craiglink/Voron-2/printer_mods/hartk1213/Voron2.4_GE5C/CAD/GE5C.step

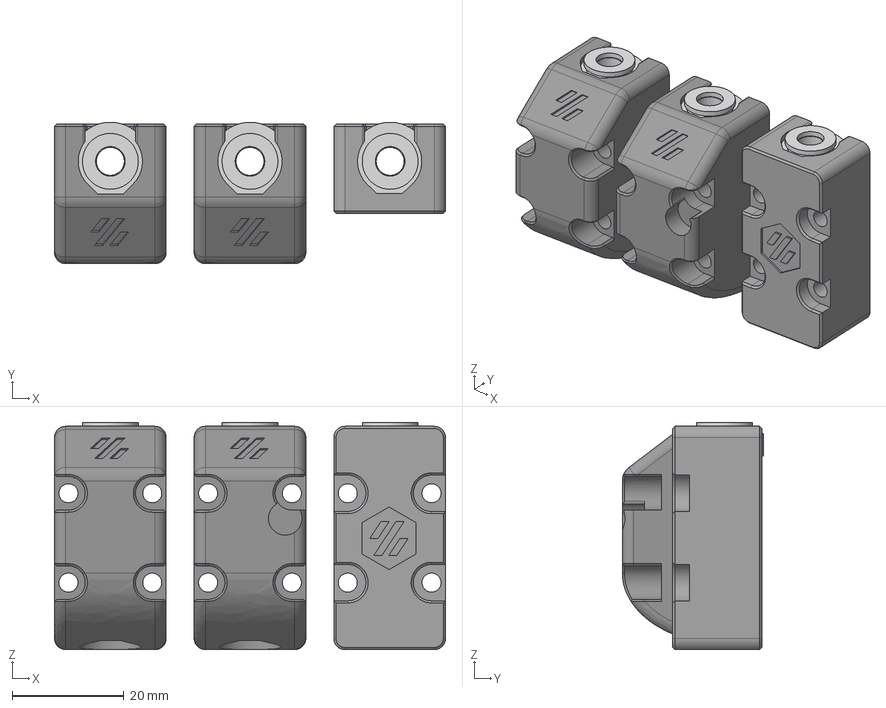
[picture p1: CAD file, 2021-08-20]
printer_mods/hartk1213/Voron2.4_GE5C/CAD/GE5C.step
70.0 x 25.3 x 40.7 mm
M5 1mm Spacer v1 (1)
GE5C v1
M5 1mm Spacer v1 (1) (1)
GE5C v1 (1)
M5 1mm Spacer v1 (1) (2)
GE5C v1 (2)
