craiglink/Voron-2/printer_mods/hartk1213/Voron2.4_GE5C/STLs/Gantry/AB Drives/b_drive_frame_lower_g5ec_offset_pinned.stl

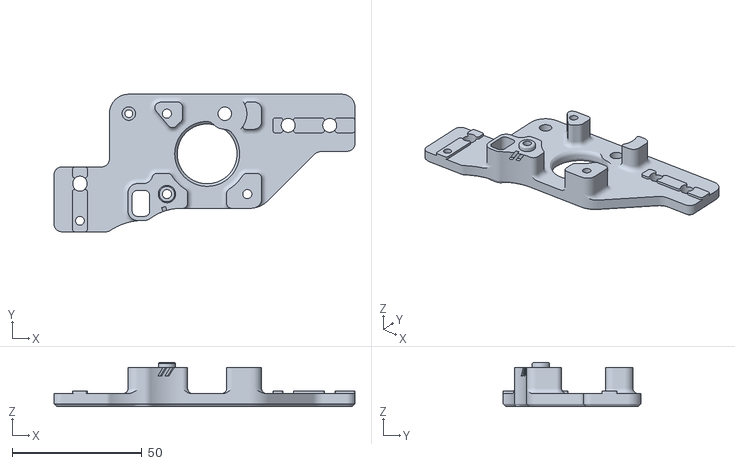
[picture p3: CAD file, 2021-08-20]
printer_mods/hartk1213/Voron2.4_GE5C/STLs/Gantry/AB Drives/b_drive_frame_lower_g5ec_offset_pinned.stl
116.0 x 53.0 x 17.0
