craiglink/Voron-2/printer_mods/hartk1213/Voron2.4_GE5C/STLs/Z_Joints/z_joint_ge5c_x4.stl

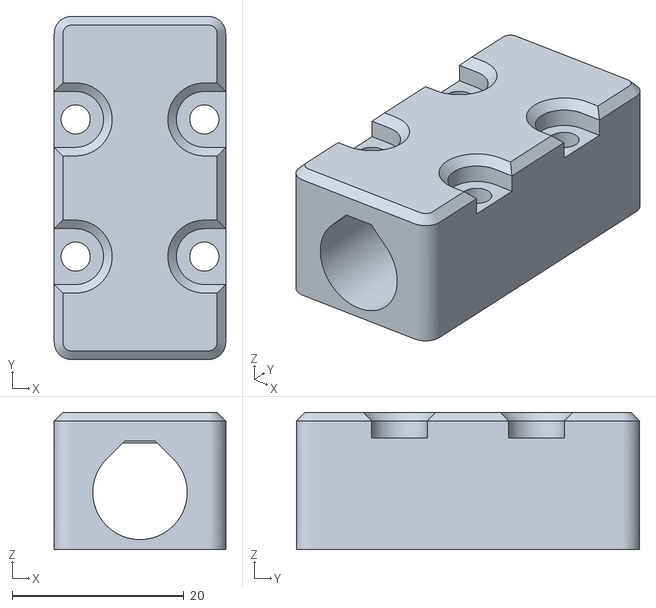
[picture p5: CAD file, 2021-08-20]
printer_mods/hartk1213/Voron2.4_GE5C/STLs/Z_Joints/z_joint_ge5c_x4.stl
20.0 x 40.0 x 16.0
