craiglink/Voron-2/printer_mods/hartk1213/Voron2.4_Pins_Mod/CAD/Gantry/AB_Drive_Units/a_drive_frame_lower_pinned.step

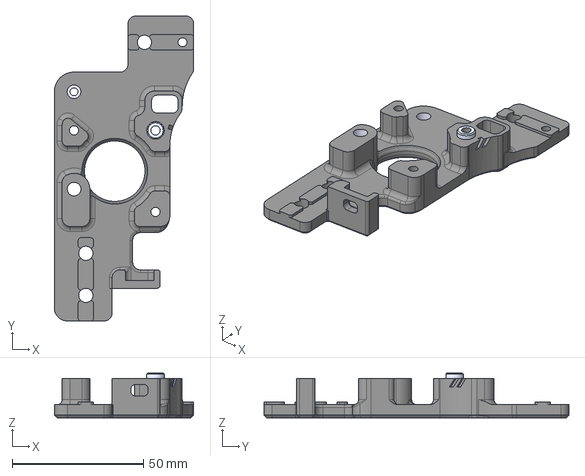
[picture p6: CAD file, 2021-08-20]
printer_mods/hartk1213/Voron2.4_Pins_Mod/CAD/Gantry/AB_Drive_Units/a_drive_frame_lower_pinned.step
53.0 x 116.0 x 17.0 mm
