craiglink/Voron-2/printer_mods/hartk1213/Voron2.4_Pins_Mod/CAD/Gantry/Front_Idlers/[a]_tensioner_right_pinned.step

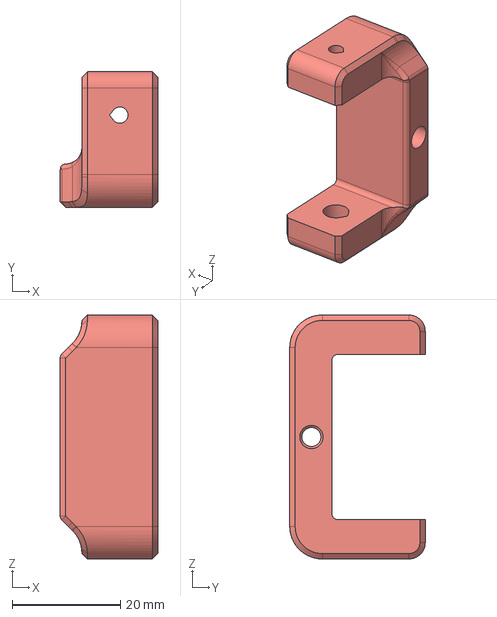
[picture p7: CAD file, 2021-08-20]
printer_mods/hartk1213/Voron2.4_Pins_Mod/CAD/Gantry/Front_Idlers/[a]_tensioner_right_pinned.step
18.0 x 25.0 x 45.0 mm
