craiglink/Voron-2/printer_mods/hartk1213/Voron2.4_Pins_Mod/CAD/Z_Idlers/z_Idler_pinned.step

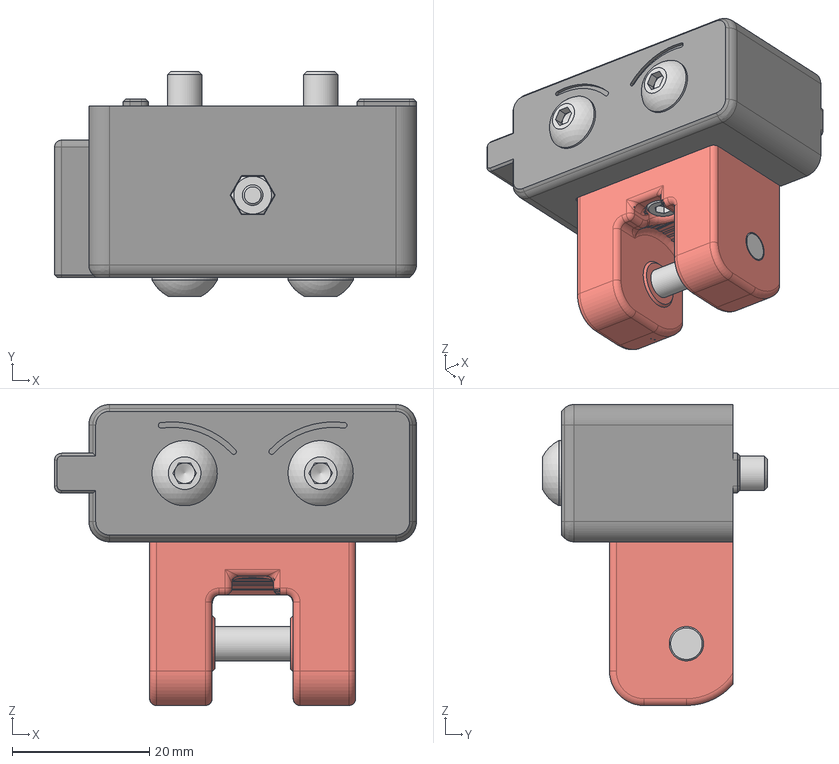
[picture p9: CAD file, 2021-08-20]
printer_mods/hartk1213/Voron2.4_Pins_Mod/CAD/Z_Idlers/z_Idler_pinned.step
52.7 x 32.8 x 43.8 mm
Z Tensioner 9mm
Z Tensioner 6mm
M5x30 BHCS (1) x 2
M3 Hexnut
M3x16 SHCS
