craiglink/Voron-2/printer_mods/hartk1213/Voron2.4_Pins_Mod/STLs/Gantry/AB_Drive_Units/a_drive_frame_upper_pinned-1.5extension.stl

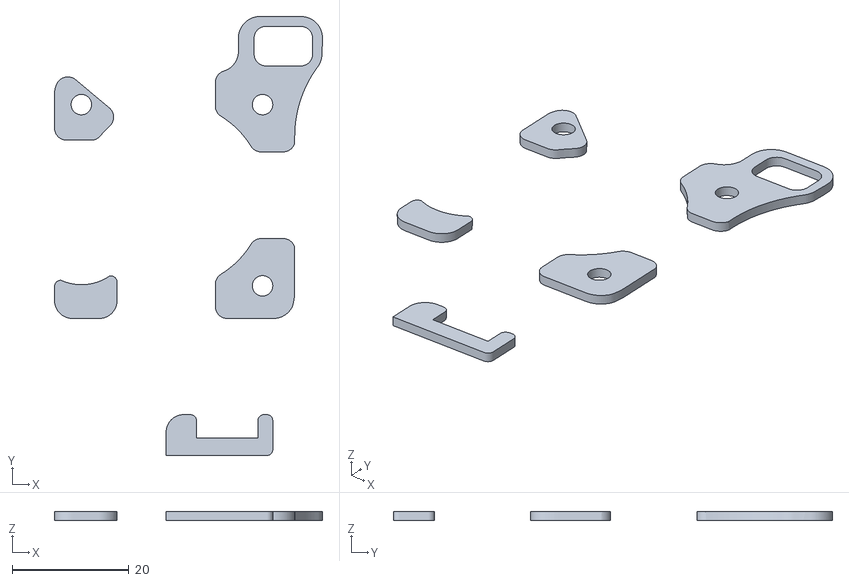
[picture p10: CAD file, 2021-08-20]
printer_mods/hartk1213/Voron2.4_Pins_Mod/STLs/Gantry/AB_Drive_Units/a_drive_frame_upper_pinned-1.5extension.stl
45.8 x 75.1 x 1.50
