craiglink/Voron-2/printer_mods/Long/Mantis_Dual_5015/1.8/Duct_v1.037_Left_+2mm.stl

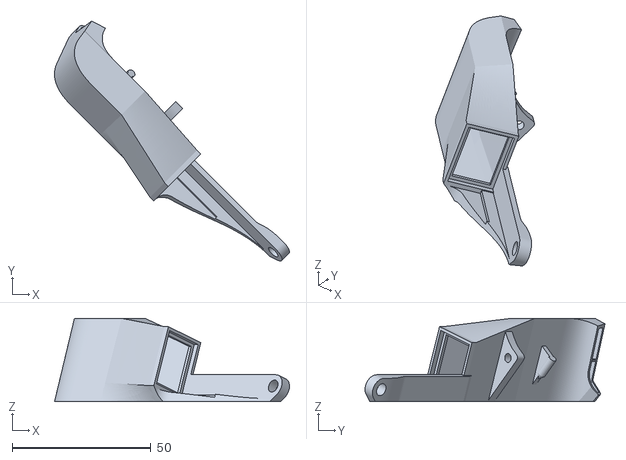
[picture p13: CAD file, 2021-08-20]
printer_mods/Long/Mantis_Dual_5015/1.8/Duct_v1.037_Left_+2mm.stl
84.6 x 86.4 x 30.0
