craiglink/Voron-2/printer_mods/Long/Mantis_Dual_5015/2.4/Duct_v1.037_Right.stl

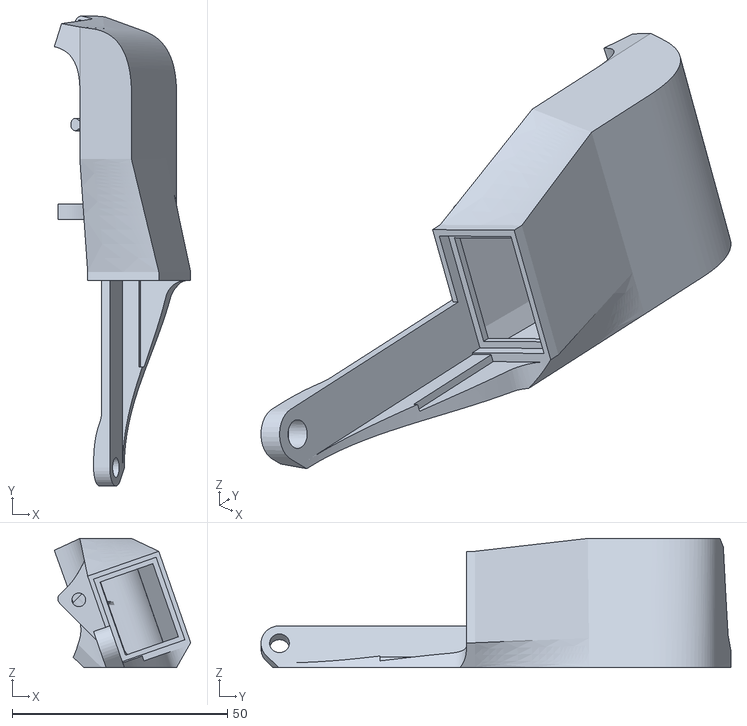
[picture p14: CAD file, 2021-08-20]
printer_mods/Long/Mantis_Dual_5015/2.4/Duct_v1.037_Right.stl
31.7 x 109.2 x 30.0
