craiglink/Voron-2/printer_mods/Long/Mantis_Dual_5015/Magprobe/Bed_Extrusion_Mount/Magprobe_Dock_Mount_v1.0.stl

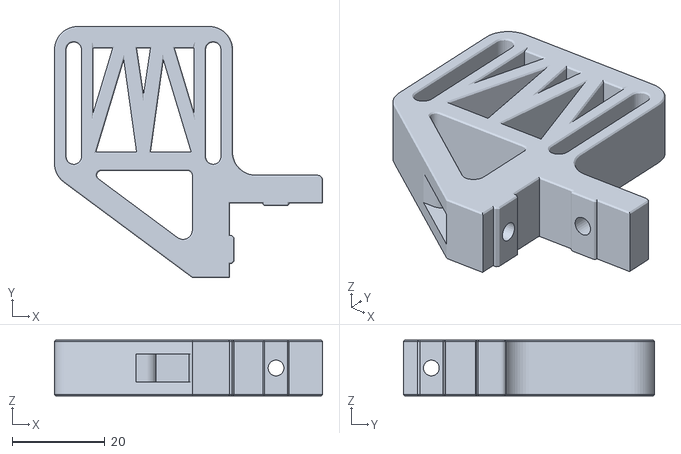
[picture p15: CAD file, 2021-08-20]
printer_mods/Long/Mantis_Dual_5015/Magprobe/Bed_Extrusion_Mount/Magprobe_Dock_Mount_v1.0.stl
57.6 x 54.0 x 12.0
