craiglink/Voron-2/printer_mods/Long/Mantis_Dual_5015/Magprobe/Gantry_Mount/Magprobe_Gantry_Dock_Arm_v1.5_Single_magnet.stl

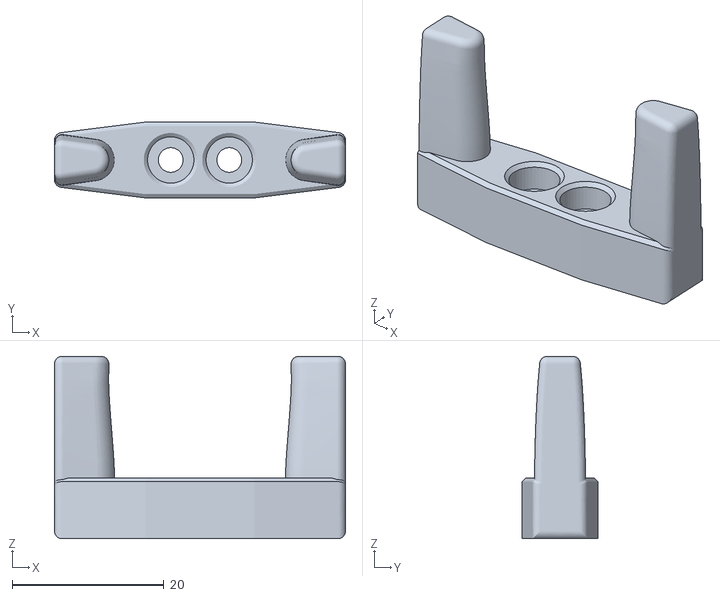
[picture p16: CAD file, 2021-08-20]
printer_mods/Long/Mantis_Dual_5015/Magprobe/Gantry_Mount/Magprobe_Gantry_Dock_Arm_v1.5_Single_magnet.stl
38.3 x 10.0 x 24.0
