craiglink/Voron-2/printer_mods/Long/Mantis_Dual_5015/Magprobe/Magprobe_v0.31.stl

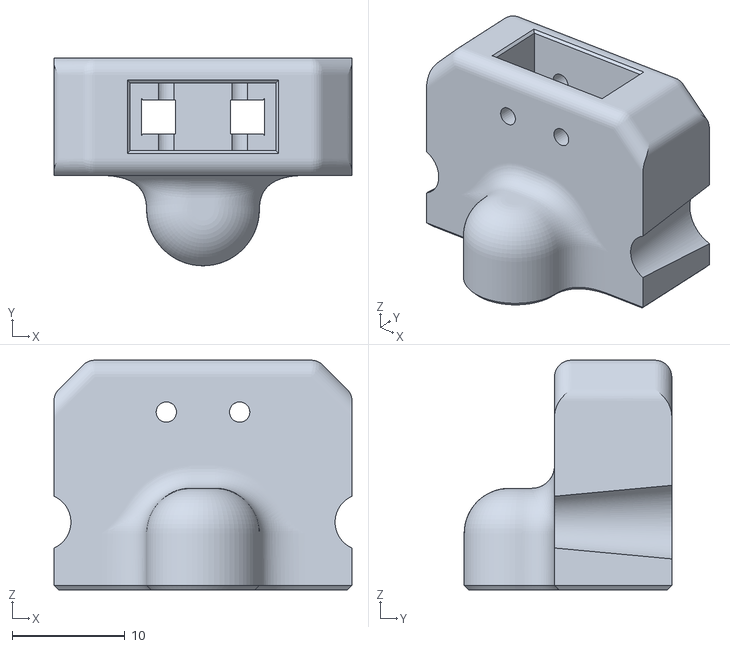
[picture p17: CAD file, 2021-08-20]
printer_mods/Long/Mantis_Dual_5015/Magprobe/Magprobe_v0.31.stl
26.4 x 18.4 x 20.4
