craiglink/Voron-2/printer_mods/Long/Mantis_Dual_5015/Umbilical_mount_v2.stl

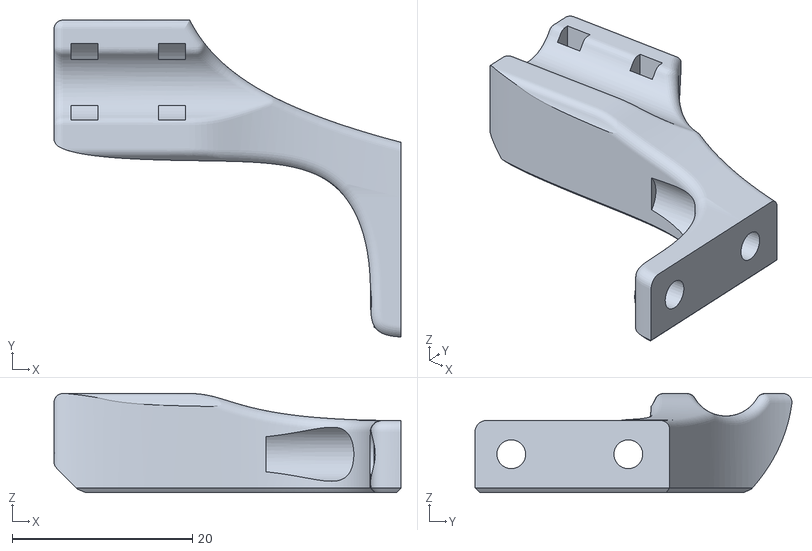
[picture p18: CAD file, 2021-08-20]
printer_mods/Long/Mantis_Dual_5015/Umbilical_mount_v2.stl
38.6 x 35.2 x 11.0
