craiglink/Voron-2/printer_mods/whoppingpochard/extrusion_backers/DXFs/Y_backer_chain-350.dxf

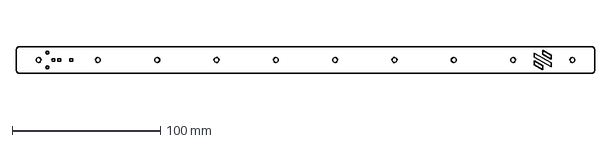
[picture p19: CAD file, 2021-08-20]
printer_mods/whoppingpochard/extrusion_backers/DXFs/Y_backer_chain-350.dxf
390.0 x 18.0 mm
