craiglink/Voron-2/printer_mods/hartk1213/Voron2.4_GE5C/STLs/Gantry/Front Idlers/a_idler_lower_g5ec_offset.stl

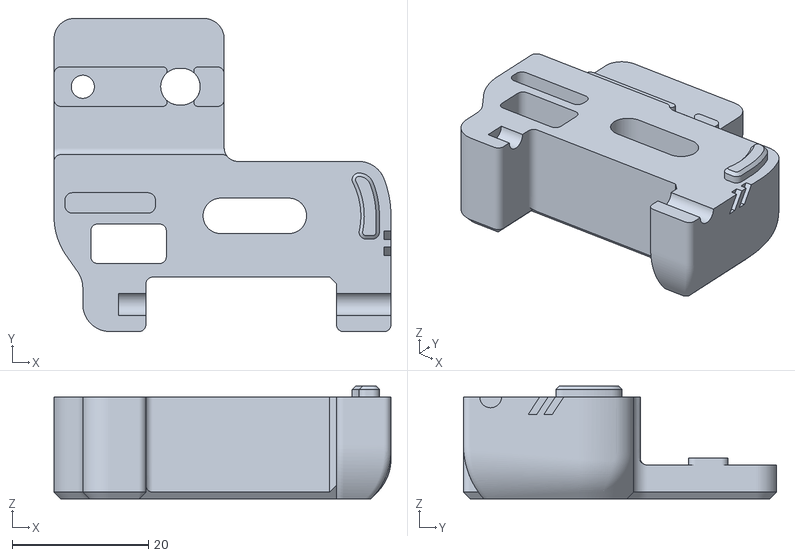
[picture p20: CAD file, 2021-08-20]
printer_mods/hartk1213/Voron2.4_GE5C/STLs/Gantry/Front Idlers/a_idler_lower_g5ec_offset.stl
49.5 x 46.0 x 16.6
