craiglink/Voron-2/printer_mods/hartk1213/Voron2.4_Pins_Mod/CAD/Gantry/AB_Drive_Units/b_drive_frame_upper_pinned.step

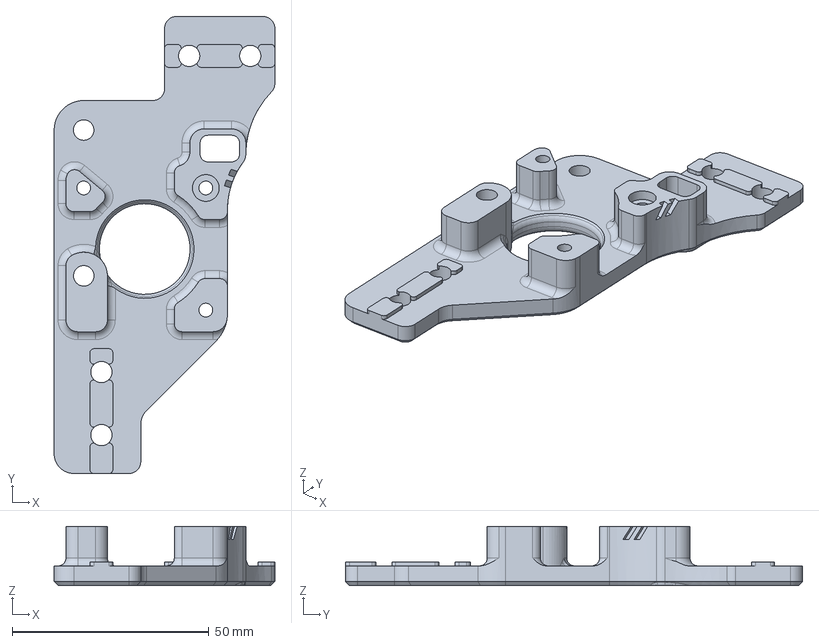
[picture p22: CAD file, 2021-08-20]
printer_mods/hartk1213/Voron2.4_Pins_Mod/CAD/Gantry/AB_Drive_Units/b_drive_frame_upper_pinned.step
56.0 x 116.0 x 15.0 mm
