craiglink/Voron-2/printer_mods/hartk1213/Voron2.4_Pins_Mod/STLs/Gantry/AB_Drive_Units/a_drive_frame_pinned.3mf

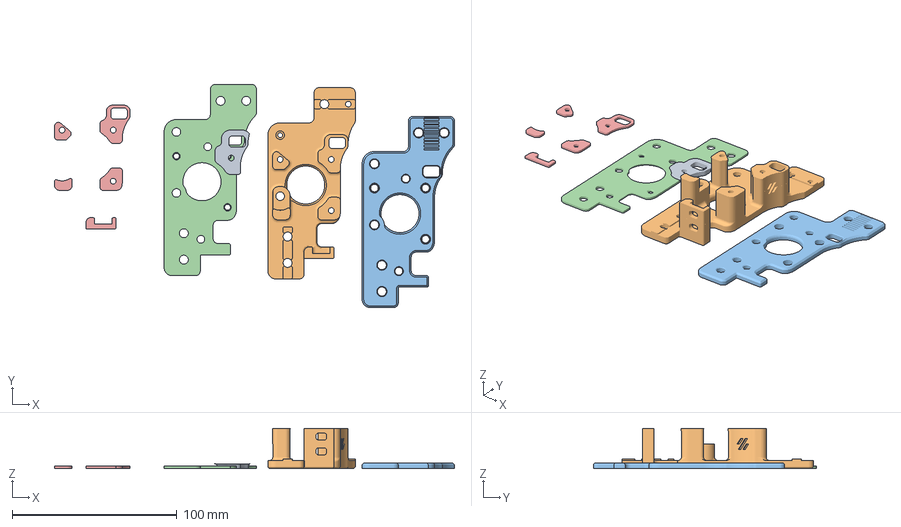
[picture p23: CAD file, 2021-08-20]
printer_mods/hartk1213/Voron2.4_Pins_Mod/STLs/Gantry/AB_Drive_Units/a_drive_frame_pinned.3mf
242.5 x 135.3 x 24.5 mm
a_drive_frame_upper_dxg_cutout.stl
a_drive_frame_upper_pinned.stl x 3
a_drive_frame_upper_dxg.stl
