craiglink/Voron-2/printer_mods/hartk1213/Voron2.4_Pins_Mod/STLs/Z_Idlers/[a]_z_tensioner_x4_6mm_pinned.stl

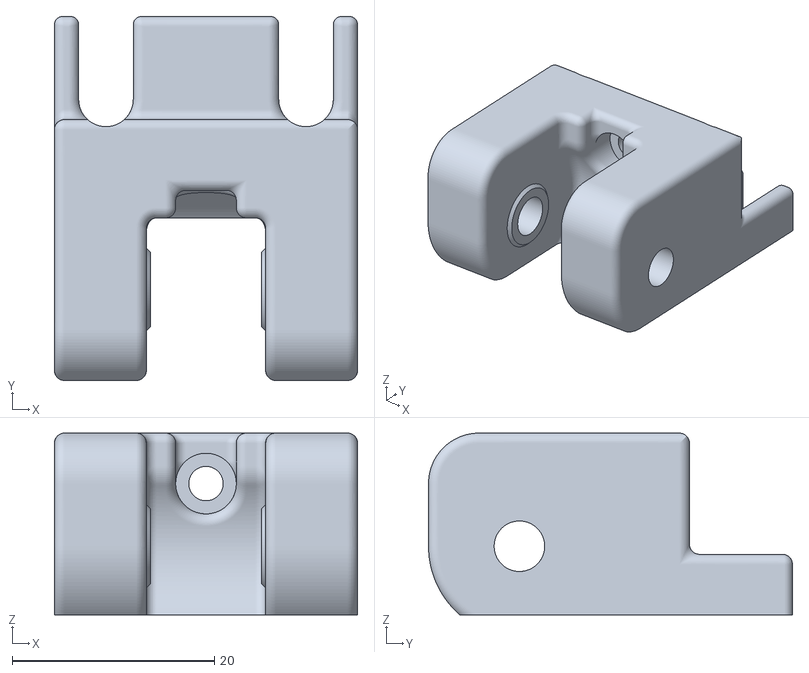
[picture p25: CAD file, 2021-08-20]
printer_mods/hartk1213/Voron2.4_Pins_Mod/STLs/Z_Idlers/[a]_z_tensioner_x4_6mm_pinned.stl
30.0 x 36.0 x 18.0
