craiglink/Voron-2/printer_mods/Long/Mantis_Dual_5015/Chain_Anchor_v3.1_IGUS.stl

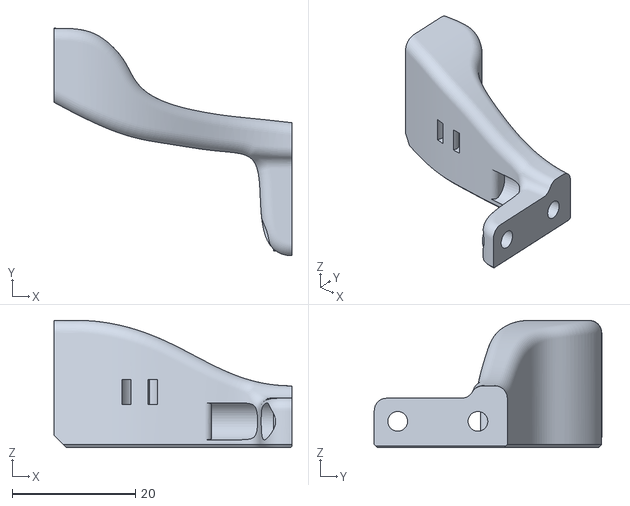
[picture p26: CAD file, 2021-08-20]
printer_mods/Long/Mantis_Dual_5015/Chain_Anchor_v3.1_IGUS.stl
38.6 x 36.9 x 20.6
