craiglink/Voron-2/printer_mods/Long/Mantis_Dual_5015/Magprobe/Bed_Extrusion_Mount/Magprobe_Dock_Arms_v1.5.stl

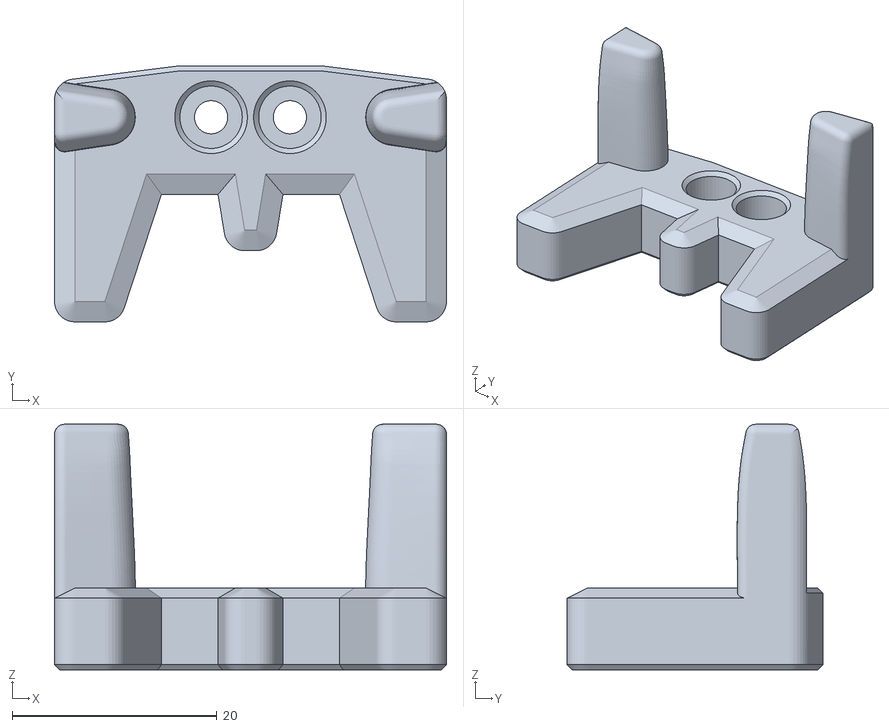
[picture p27: CAD file, 2021-08-20]
printer_mods/Long/Mantis_Dual_5015/Magprobe/Bed_Extrusion_Mount/Magprobe_Dock_Arms_v1.5.stl
38.3 x 25.0 x 24.0
