craiglink/Voron-2/printer_mods/whoppingpochard/extrusion_backers/DXFs/X_backer_chain-200.dxf

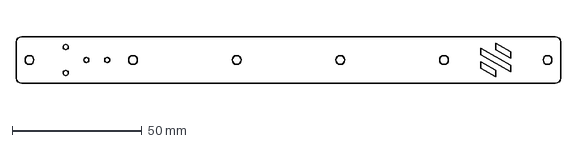
[picture p29: CAD file, 2021-08-20]
printer_mods/whoppingpochard/extrusion_backers/DXFs/X_backer_chain-200.dxf
210.0 x 18.0 mm
