craiglink/Voron-2/printer_mods/hartk1213/Voron2.4_Pins_Mod/STLs/Gantry/X_Axis/XY_Joints/xy_joint_left_upper_pinned.stl

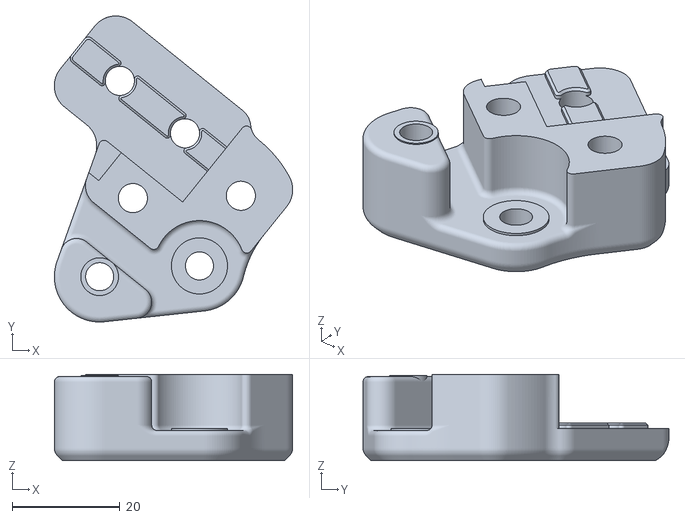
[picture p31: CAD file, 2021-08-20]
printer_mods/hartk1213/Voron2.4_Pins_Mod/STLs/Gantry/X_Axis/XY_Joints/xy_joint_left_upper_pinned.stl
44.2 x 56.7 x 16.0
