craiglink/Voron-2/printer_mods/Long/Mantis_Dual_5015/Magprobe/Gantry_Mount/Magprobe_Gantry_Dock_Mount_by_JosAr_v1.stl

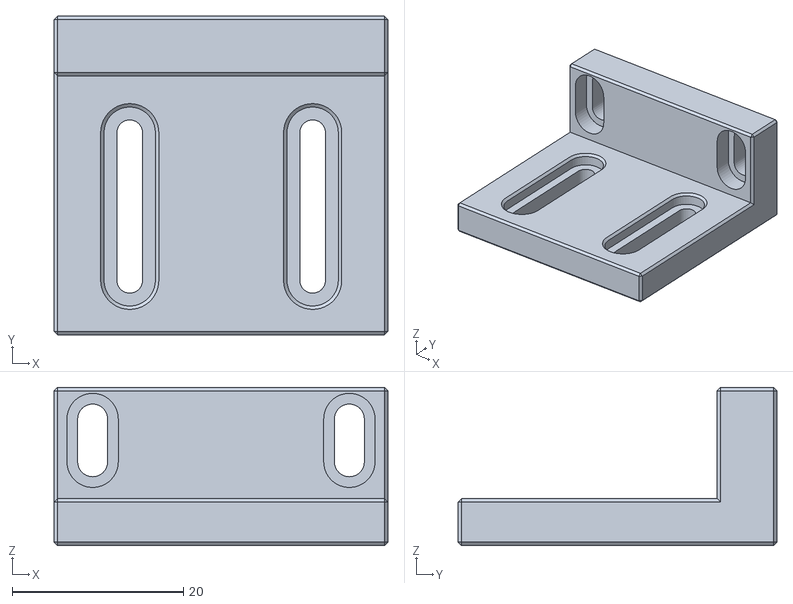
[picture p32: CAD file, 2021-08-20]
printer_mods/Long/Mantis_Dual_5015/Magprobe/Gantry_Mount/Magprobe_Gantry_Dock_Mount_by_JosAr_v1.stl
39.0 x 37.3 x 18.5
