craiglink/Voron-2/printer_mods/Long/Mantis_Dual_5015/Mount_dragon_v1.037.stl

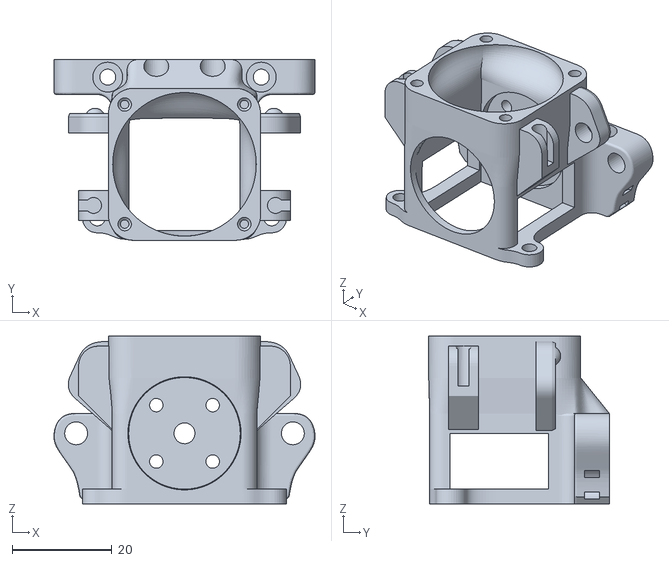
[picture p33: CAD file, 2021-08-20]
printer_mods/Long/Mantis_Dual_5015/Mount_dragon_v1.037.stl
52.4 x 36.2 x 33.7
