craiglink/Voron-2/printer_mods/Long/Mantis_Dual_5015/Chain_Anchor_v3.2.stl

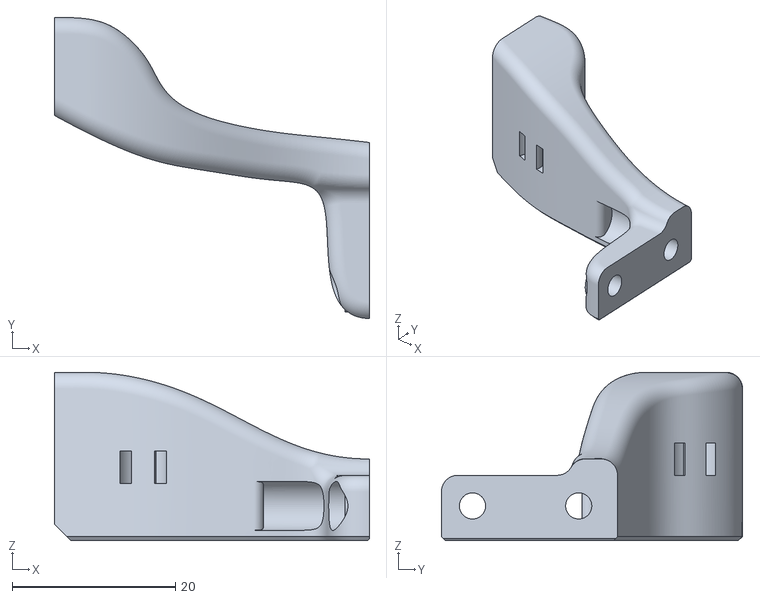
[picture p36: CAD file, 2021-08-20]
printer_mods/Long/Mantis_Dual_5015/Chain_Anchor_v3.2.stl
38.6 x 36.8 x 20.6
