craiglink/Voron-2/printer_mods/Long/Mantis_Dual_5015/Magprobe/Gantry_Mount/Magprobe_Gantry_Dock_Arm_v1.5_double_magnet.stl

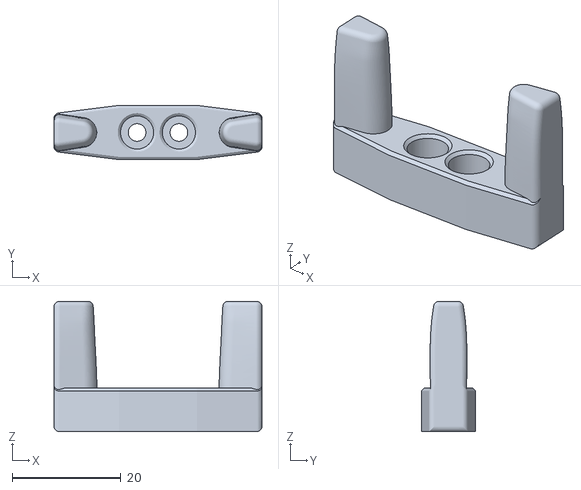
[picture p37: CAD file, 2021-08-20]
printer_mods/Long/Mantis_Dual_5015/Magprobe/Gantry_Mount/Magprobe_Gantry_Dock_Arm_v1.5_double_magnet.stl
38.3 x 10.0 x 24.0
