craiglink/Voron-2/printer_mods/hartk1213/Voron2.4_Pins_Mod/STLs/Gantry/X_Axis/XY_Joints/MGN12_xy_joint_right_upper_pinned.stl

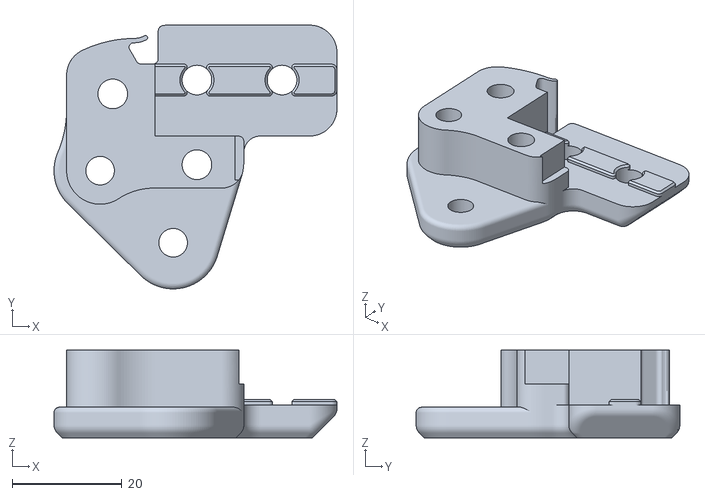
[picture p39: CAD file, 2021-08-20]
printer_mods/hartk1213/Voron2.4_Pins_Mod/STLs/Gantry/X_Axis/XY_Joints/MGN12_xy_joint_right_upper_pinned.stl
51.5 x 48.0 x 16.0
