craiglink/Voron-2/printer_mods/Long/Mantis_Dual_5015/Carriage_v1.037.stl

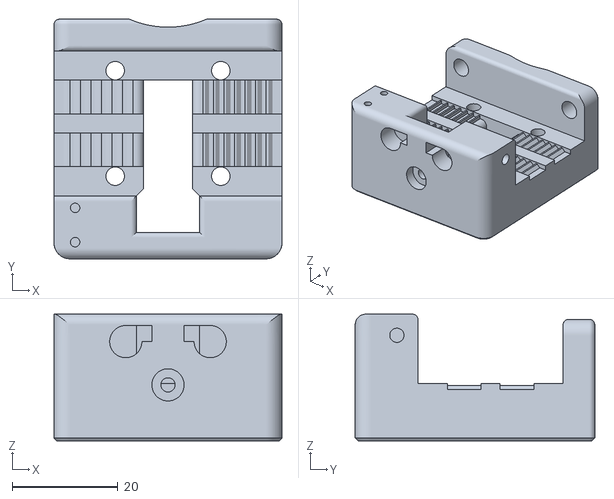
[picture p40: CAD file, 2021-08-20]
printer_mods/Long/Mantis_Dual_5015/Carriage_v1.037.stl
43.2 x 45.4 x 24.0
