craiglink/Voron-2/printer_mods/Long/Mantis_Dual_5015/Magprobe/Gantry_Mount/Magprobe_Gantry_Extrusion_Mount_by_JosAr_v1.stl

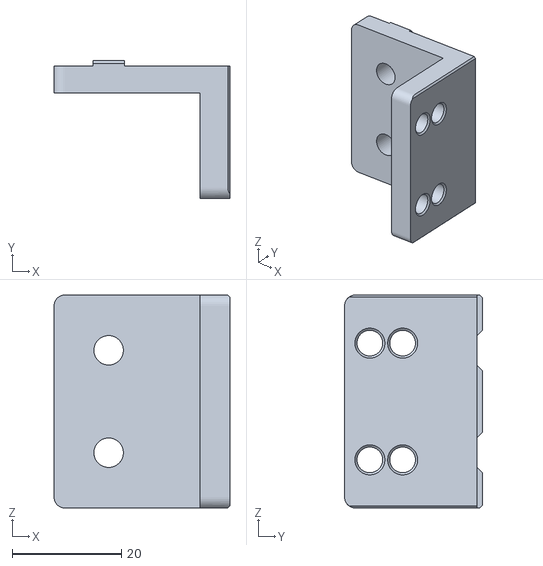
[picture p41: CAD file, 2021-08-20]
printer_mods/Long/Mantis_Dual_5015/Magprobe/Gantry_Mount/Magprobe_Gantry_Extrusion_Mount_by_JosAr_v1.stl
32.2 x 25.3 x 39.0
