craiglink/Voron-2/printer_mods/hartk1213/Voron2.4_Pins_Mod/STLs/Gantry/X_Axis/XY_Joints/xy_joint_left_lower_pinned.stl

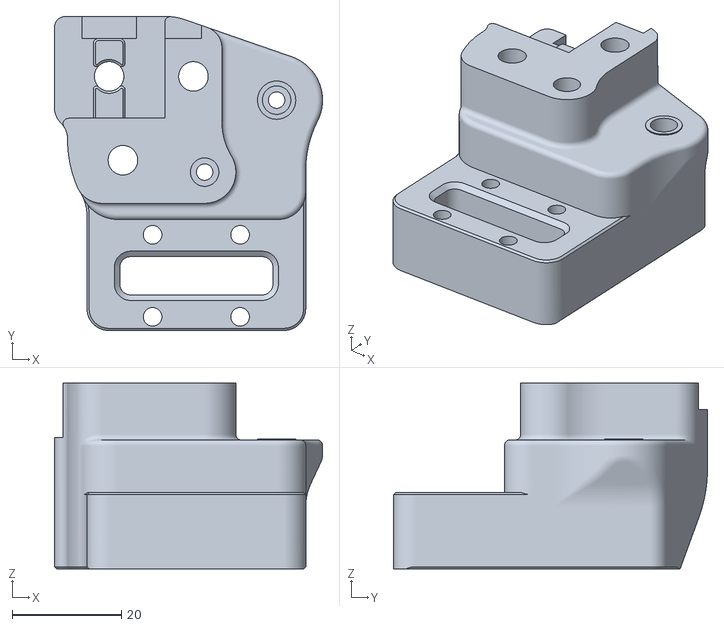
[picture p43: CAD file, 2021-08-20]
printer_mods/hartk1213/Voron2.4_Pins_Mod/STLs/Gantry/X_Axis/XY_Joints/xy_joint_left_lower_pinned.stl
49.0 x 57.4 x 34.0
