craiglink/Voron-2/printer_mods/whoppingpochard/extrusion_backers/DXFs/Y_backer_chain-250.dxf

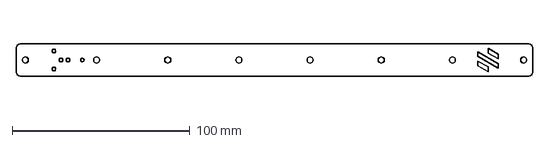
[picture p44: CAD file, 2021-08-20]
printer_mods/whoppingpochard/extrusion_backers/DXFs/Y_backer_chain-250.dxf
290.0 x 18.0 mm
