craiglink/Voron-2/printer_mods/whoppingpochard/extrusion_backers/DXFs/Y_backer-200.dxf

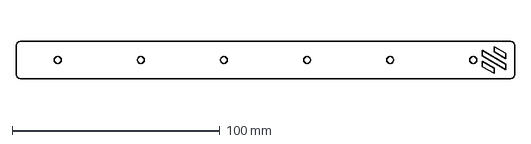
[picture p46: CAD file, 2021-08-20]
printer_mods/whoppingpochard/extrusion_backers/DXFs/Y_backer-200.dxf
240.0 x 18.0 mm
