craiglink/Voron-2/printer_mods/whoppingpochard/extrusion_backers/DXFs/Y_backer_chain-300.dxf

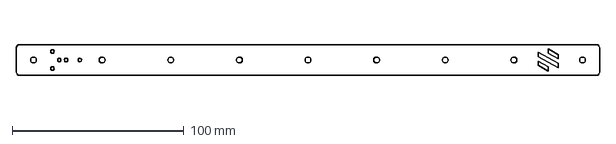
[picture p49: CAD file, 2021-08-20]
printer_mods/whoppingpochard/extrusion_backers/DXFs/Y_backer_chain-300.dxf
340.0 x 18.0 mm
