craiglink/Voron-2/printer_mods/whoppingpochard/extrusion_backers/DXFs/X_backer_chain-300.dxf

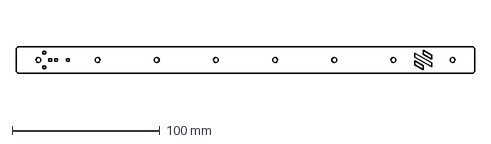
[picture p52: CAD file, 2021-08-20]
printer_mods/whoppingpochard/extrusion_backers/DXFs/X_backer_chain-300.dxf
310.0 x 18.0 mm
