craiglink/Voron-2/(list of files, cad)

Other CAD files:
printer_mods/hartk1213/Voron2.4_Pins_Mod/STLs/Gantry/Front_Idlers/[a]_b_tensioner_pinned.stl
printer_mods/hartk1213/Voron2.4_GE5C/STLs/Gantry/AB Drives/a_drive_frame_lower_g5ec_offset.stl
printer_mods/hartk1213/Voron2.4_Pins_Mod/CAD/Gantry/Front_Idlers/[a]_tensioner_left_pinned.step
printer_mods/hartk1213/Voron2.4_Pins_Mod/STLs/Gantry/Front_Idlers/[a]_a_tensioner_pinned.stl
printer_mods/Long/Mantis_Dual_5015/1.8/Duct_v1.037_Right_+2mm.stl
printer_mods/Long/Mantis_Dual_5015/2.4/Duct_v1.037_Left.stl
printer_mods/hartk1213/Voron2.4_GE5C/STLs/Gantry/AB Drives/b_drive_frame_lower_g5ec_offset.stl
printer_mods/hartk1213/Voron2.4_GE5C/STLs/Gantry/Front Idlers/a_idler_lower_g5ec_offset_pinned.stl
printer_mods/hartk1213/Voron2.4_Pins_Mod/CAD/Gantry/AB_Drive_Units/a_drive_frame_upper_pinned.step
printer_mods/hartk1213/Voron2.4_GE5C/STLs/Gantry/AB Drives/a_drive_frame_lower_g5ec_offset_pinned.stl
printer_mods/hartk1213/Voron2.4_GE5C/STLs/Gantry/Front Idlers/b_idler_lower_g5ec_offset.stl
printer_mods/hartk1213/Voron2.4_Pins_Mod/CAD/Gantry/AB_Drive_Units/b_drive_frame_lower_pinned.step
printer_mods/Long/Mantis_Dual_5015/Magprobe/Bed_Extrusion_Mount/Magprobe_Dock_Arms_v1.0.stl
printer_mods/hartk1213/Voron2.4_Pins_Mod/STLs/Gantry/AB_Drive_Units/a_drive_frame_lower_pinned.stl
printer_mods/hartk1213/Voron2.4_Pins_Mod/STLs/Gantry/AB_Drive_Units/a_drive_frame_upper_pinned.stl
printer_mods/hartk1213/Voron2.4_Pins_Mod/STLs/Gantry/AB_Drive_Units/b_drive_frame_lower_pinned.stl
printer_mods/hartk1213/Voron2.4_Pins_Mod/STLs/Gantry/AB_Drive_Units/b_drive_frame_upper_pinned.stl
printer_mods/whoppingpochard/extrusion_backers/CAD/backer_sim.f3z
