craiglink/Voron-2/printer_mods/whoppingpochard/extrusion_backers/images/backers_blued.jpeg

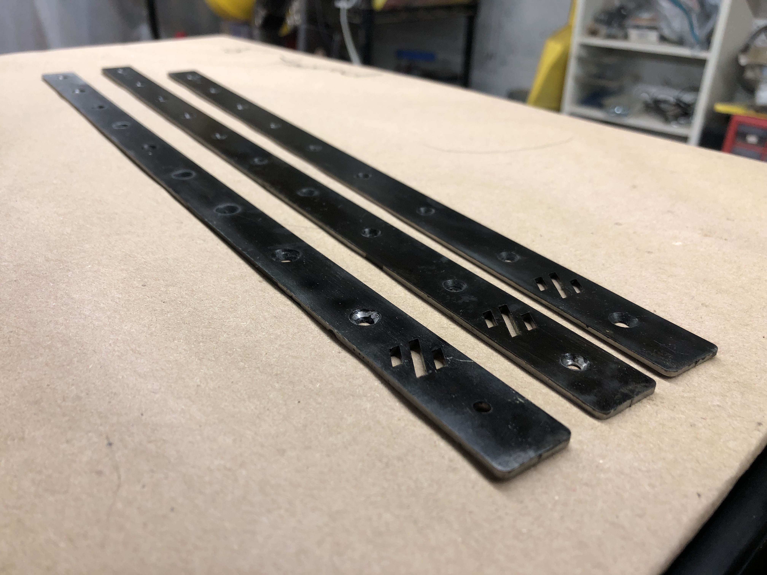
printer_mods/whoppingpochard/extrusion_backers/images/backers_blued.jpeg
